felge1966/Picox-8/README.md

PicoX-8: Universalerweiterung für den Epson PX-8

https://forum.classic-computing.de/forum/index.php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

PicoX-8 Block Diagram
