felge1966/Picox-8/PicoX-8 Block Diagram.png

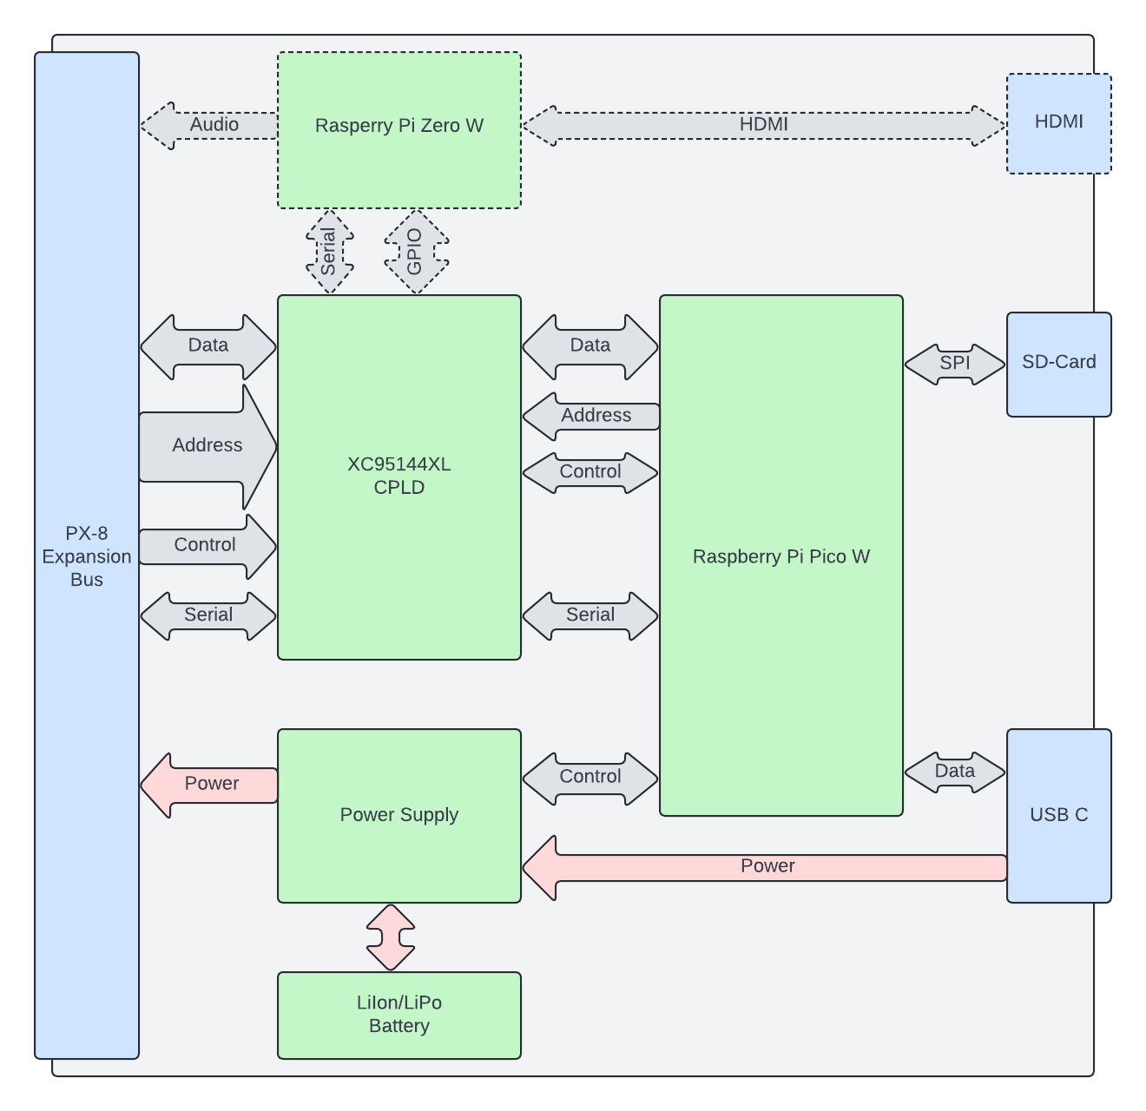
PicoX-8 Block Diagram.png
