felge1966/Picox-8/pcb/3dmodels/SD_Card.step

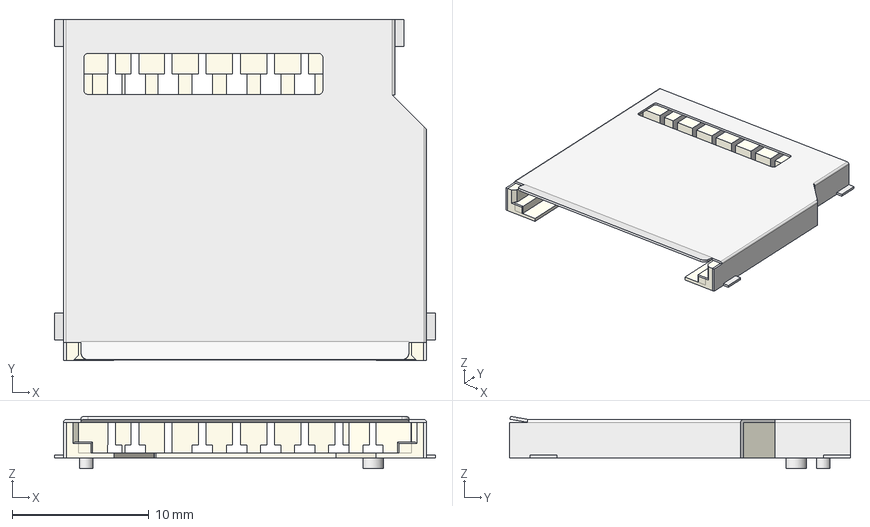
[picture p2: CAD file, 2024-11-17]
pcb/3dmodels/SD_Card.step
27.9 x 25.0 x 3.84 mm
Metal_Case
Bottom_Socket
