felge1966/Picox-8/pcb/3dmodels/Mini-DIN-6P.step

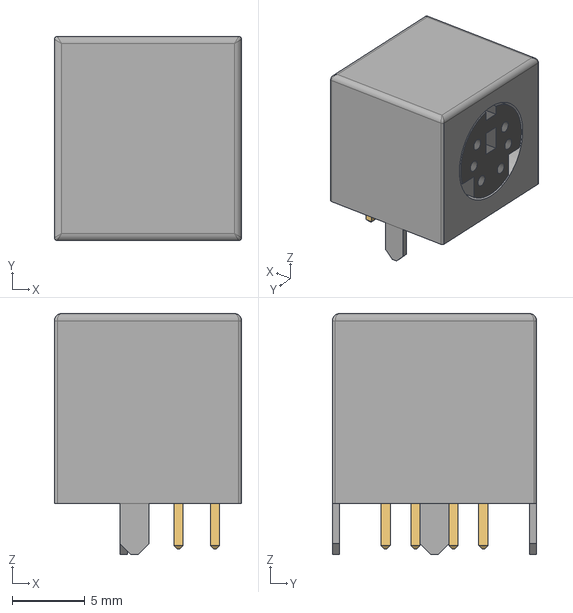
[picture p3: CAD file, 2024-11-17]
pcb/3dmodels/Mini-DIN-6P.step
12.8 x 14.0 x 16.5 mm
