felge1966/Picox-8/pcb/3dmodels/Wuerth SD Card 693063010911.step

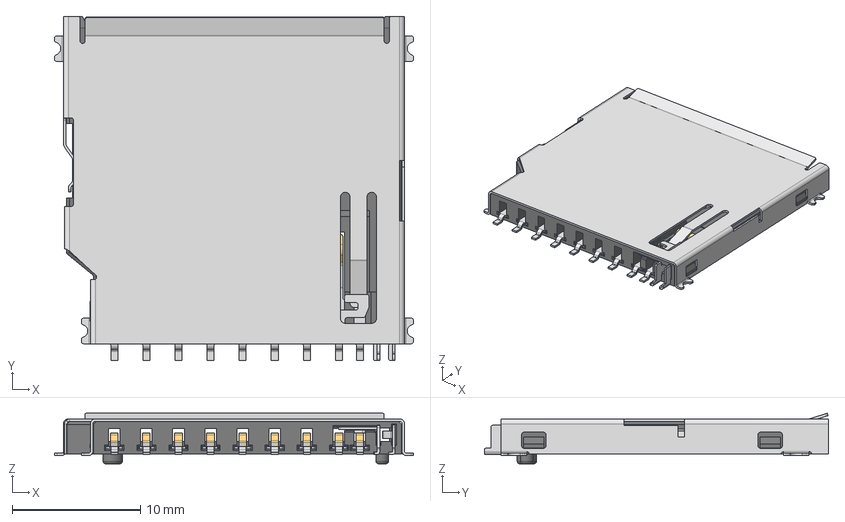
[picture p4: CAD file, 2024-11-17]
pcb/3dmodels/Wuerth SD Card 693063010911.step
28.0 x 26.8 x 3.95 mm
693063010911_Housing
693063010911_PIN_CONTACT
693063010911_PIN_RETENTION
693063010911_PIN_P x 5
693063010911_PIN_M
693063010911_PIN_G x 2
693063010911_PIN_TG
693063010911_Shielding
