felge1966/Picox-8/pcb/picox-8.kicad_pcb

## KiCad design pcb/picox-8.kicad_pcb (2024-11-17)

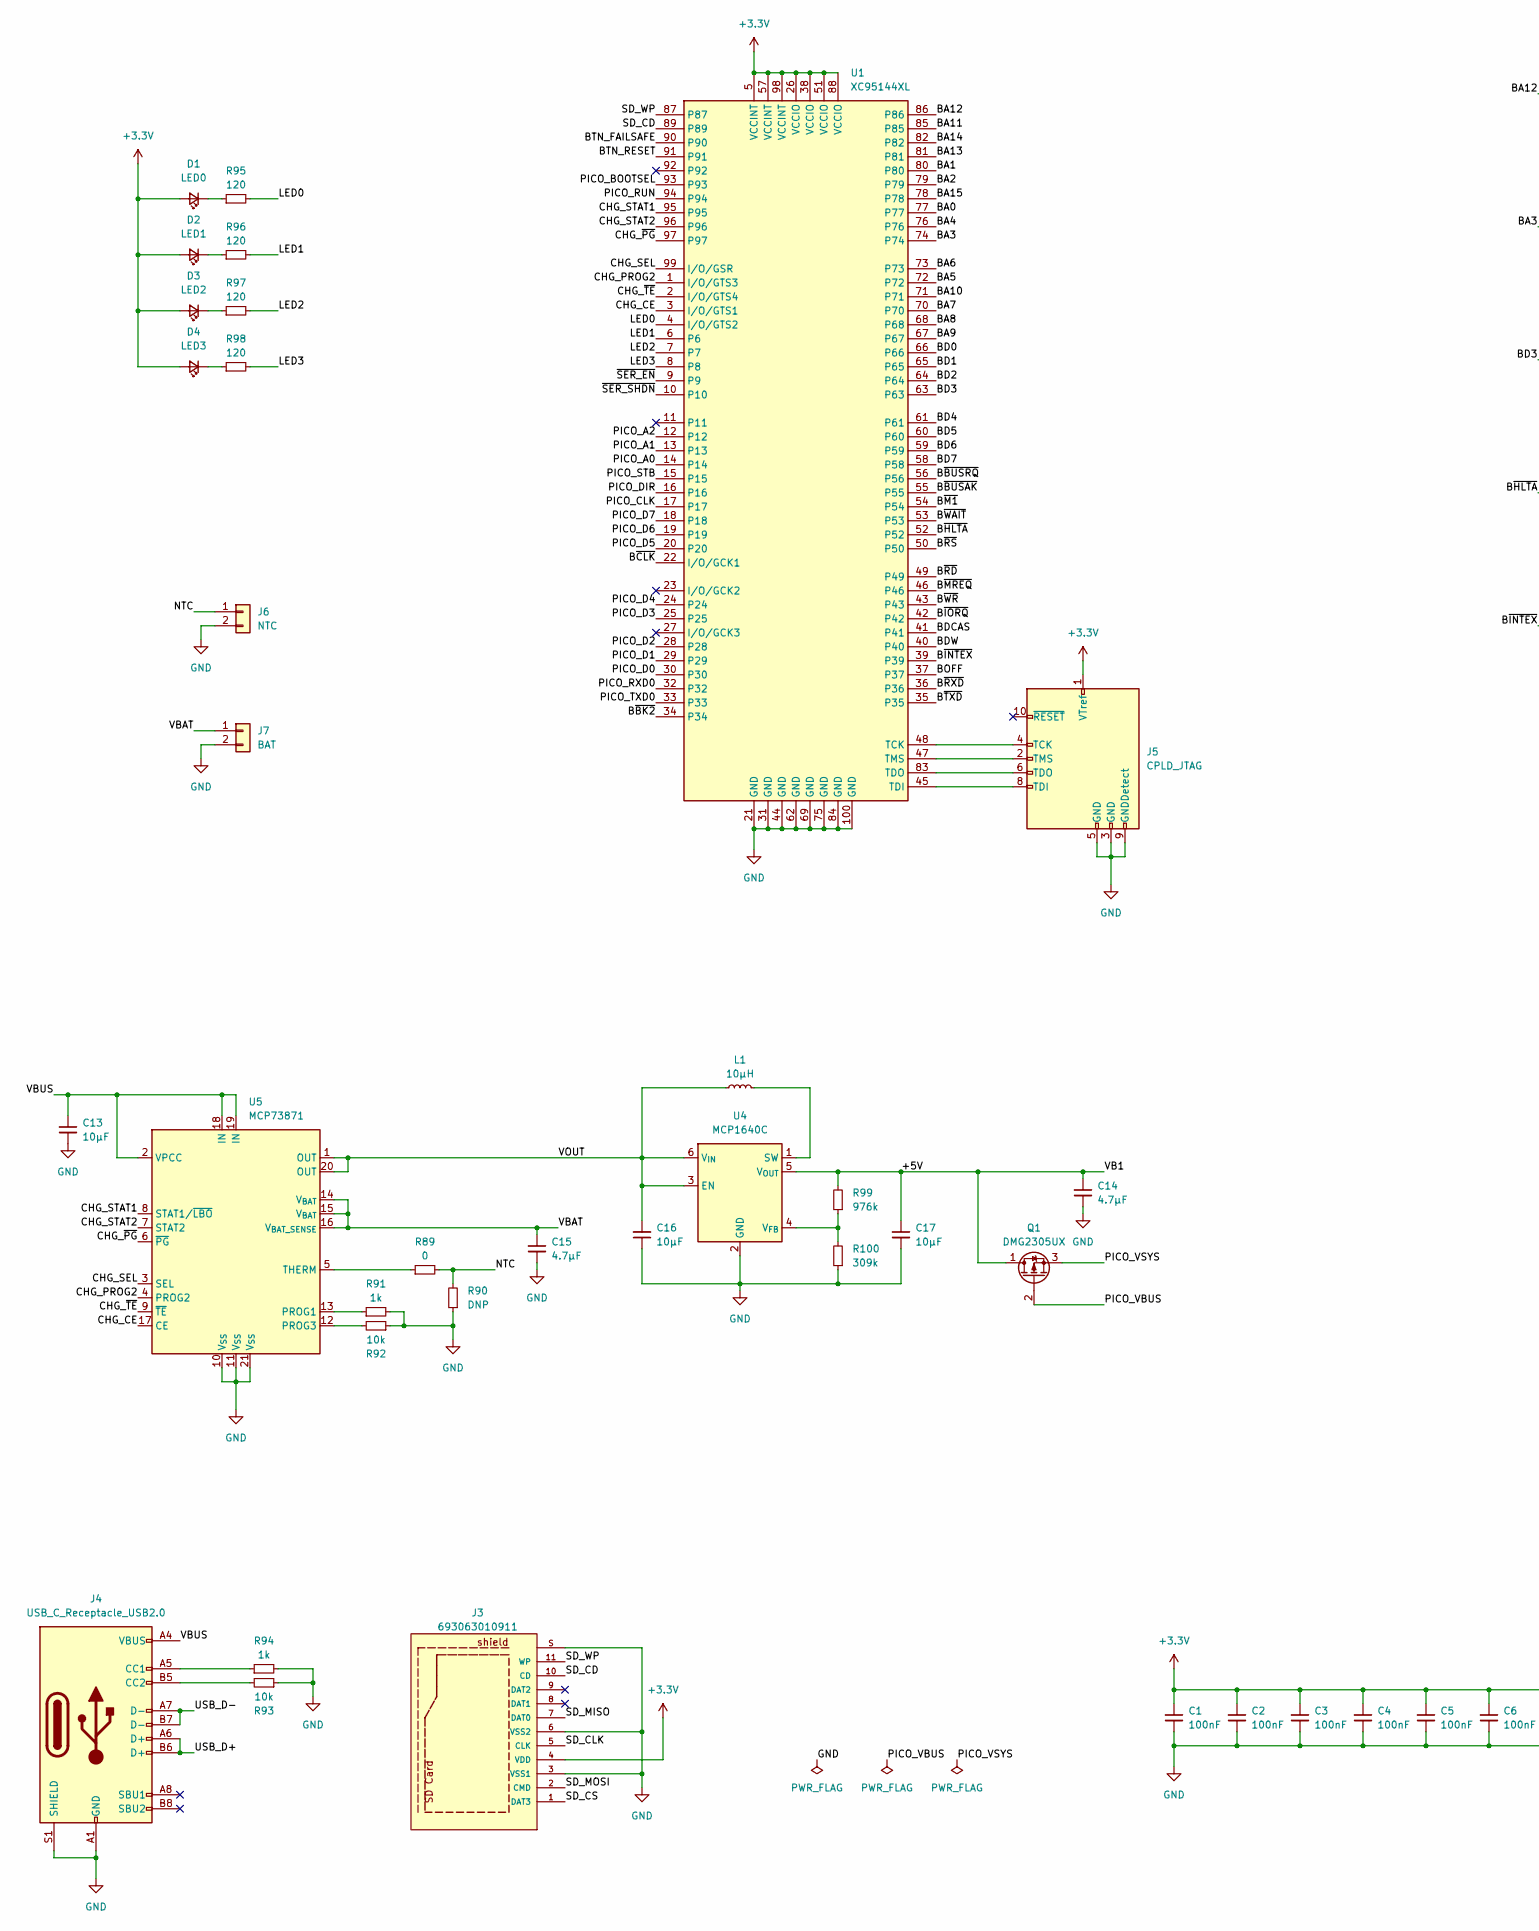
[picture p5: schematic picox-8.kicad_sch, part in row 1, column 1]

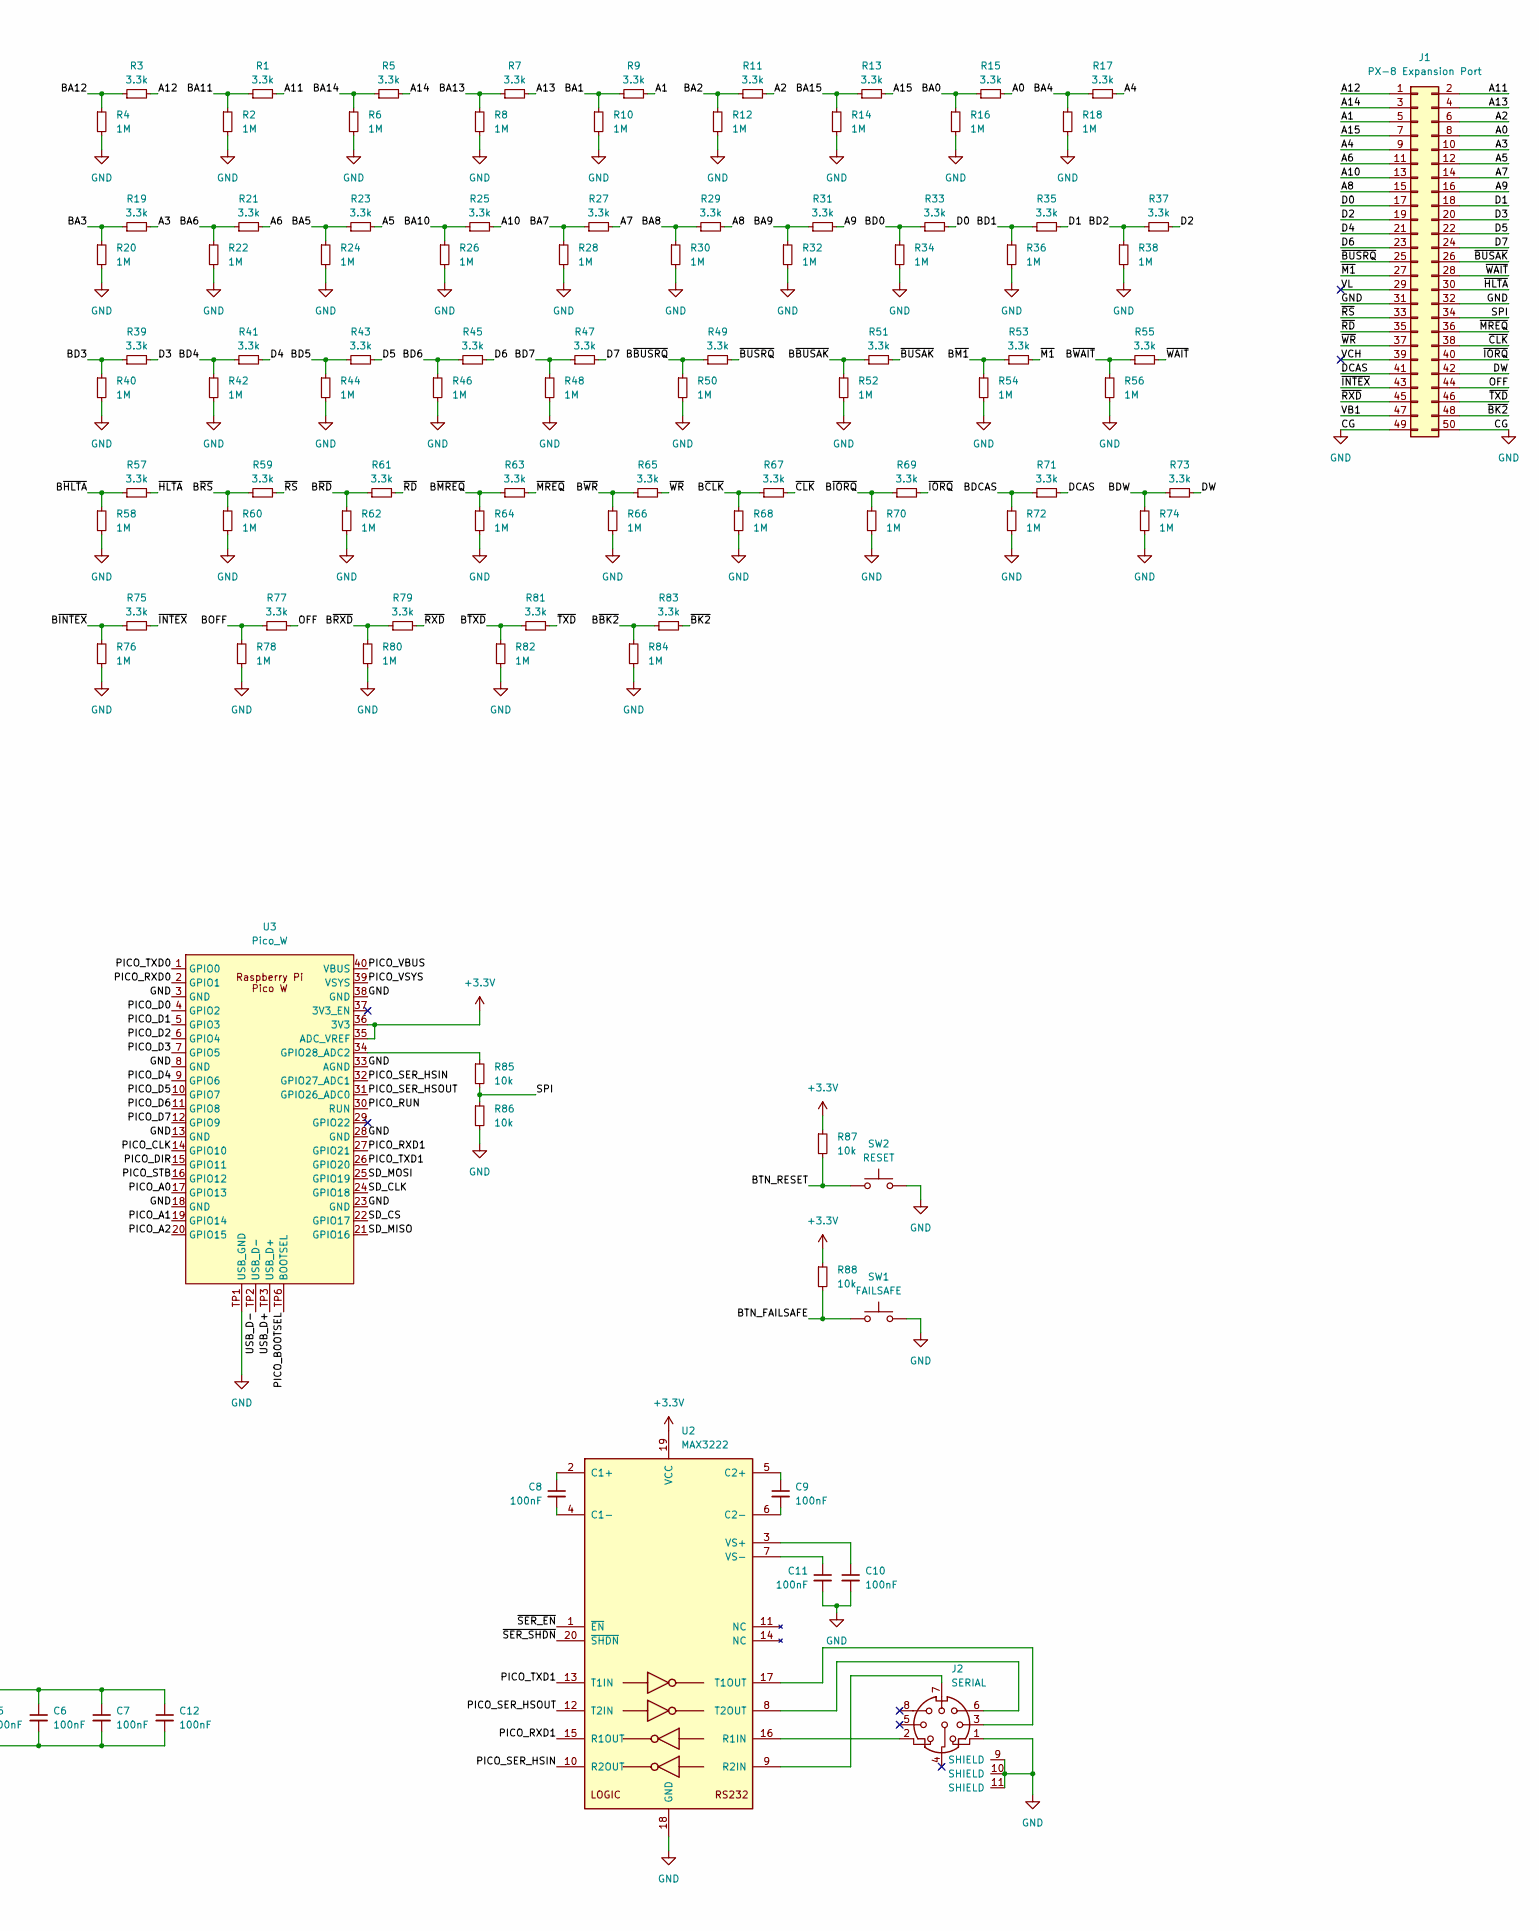
[picture p6: schematic picox-8.kicad_sch, part in row 1, column 2]

Parts:
C1, C2, C3, C4, C5, C6, C7, C8, C9, C10, C11, C12: 100nF; C_0603_1608Metric_Pad1.08x0.95mm_HandSolder
C13, C16, C17: 10μF; C_0603_1608Metric_Pad1.08x0.95mm_HandSolder
C14, C15: 4.7μF; C_0603_1608Metric_Pad1.08x0.95mm_HandSolder
D1: LED0; LED_0603_1608Metric_Pad1.05x0.95mm_HandSolder
D2: LED1; LED_0603_1608Metric_Pad1.05x0.95mm_HandSolder
D3: LED2; LED_0603_1608Metric_Pad1.05x0.95mm_HandSolder
D4: LED3; LED_0603_1608Metric_Pad1.05x0.95mm_HandSolder
J1: PX-8 Expansion Port; IDC-Header_2x25_P2.54mm_Latch_Horizontal
J2: SERIAL; minidin-8
J3: 693063010911; Wuerth SD Card 693063010911; PART-NUMBER 693063010911
J4: USB_C_Receptacle_USB2.0; USB_C_Receptacle_G-Switch_GT-USB-7010ASV
J5: CPLD_JTAG; IDC-Header_2x05_P2.54mm_Vertical
J6: NTC; PinHeader_1x02_P2.54mm_Vertical
J7: BAT; JST_EH_S2B-EH_1x02_P2.50mm_Horizontal
L1: 10µH; L_Radial_D6.0mm_P4.00mm
Q1: DMG2305UX; SOT-23-3
R1, R3, R5, R7, R9, R11, R13, R15, R17, R19, R21, R23, R25, R27, R29, R31, R33, R35, R37, R39, R41, R43, R45, R47, R49, R51, R53, R55, R57, R59, R61, R63, R65, R67, R69, R71, R73, R75, R77, R79, R81, R83: 3.3k; R_0603_1608Metric_Pad0.98x0.95mm_HandSolder
R2, R4, R6, R8, R10, R12, R14, R16, R18, R20, R22, R24, R26, R28, R30, R32, R34, R36, R38, R40, R42, R44, R46, R48, R50, R52, R54, R56, R58, R60, R62, R64, R66, R68, R70, R72, R74, R76, R78, R80, R82, R84: 1M; R_0603_1608Metric_Pad0.98x0.95mm_HandSolder
R85, R86, R87, R88, R92, R93: 10k; R_0603_1608Metric_Pad0.98x0.95mm_HandSolder
R89: 0; R_0603_1608Metric_Pad0.98x0.95mm_HandSolder
R90: DNP; R_0603_1608Metric_Pad0.98x0.95mm_HandSolder
R91, R94: 1k; R_0603_1608Metric_Pad0.98x0.95mm_HandSolder
R95, R96, R97, R98: 120; R_0603_1608Metric_Pad0.98x0.95mm_HandSolder
R99: 976k; R_0603_1608Metric_Pad0.98x0.95mm_HandSolder
R100: 309k; R_0603_1608Metric_Pad0.98x0.95mm_HandSolder
SW1: FAILSAFE; SW_Tactile_SPST_Angled_PTS645Vx39-2LFS
SW2: RESET; SW_Tactile_SPST_Angled_PTS645Vx39-2LFS
U1: XC95144XL; TQFP-100_14x14mm_P0.5mm
U2: MAX3222; TSSOP-20_4.4x6.5mm_P0.65mm
U3: Pico_W; RPI Pico W USB and Prog
U4: MCP1640C; SOT-23-6
U5: MCP73871; QFN-20-1EP_4x4mm_P0.5mm_EP2.5x2.5mm

Connections:
+3.3V: C1.1, C2.1, C3.1, C4.1, C5.1, C6.1, C7.1, C12.1, D1.2 (A), D2.2 (A), D3.2 (A), D4.2 (A), J3.4 (VDD), J5.1 (VTref), R87.1, R88.1, U1.5 (VCCINT), U1.26 (VCCIO), U1.38 (VCCIO), U1.51 (VCCIO), U1.57 (VCCINT), U1.88 (VCCIO), U1.98 (VCCINT), U2.19 (VCC), U3.35 (ADC_VREF), U3.36 (3V3)
/+5V: C14.1, C17.1, J1.47 (VB1), Q1.1 (D), R99.2, U4.5 (V_{OUT})
/A0: J1.8 (A0), R15.2
/A1: J1.5 (A1), R9.2
/A2: J1.6 (A2), R11.2
/A3: J1.10 (A3), R19.2
/A4: J1.9 (A4), R17.2
/A5: J1.12 (A5), R23.2
/A6: J1.11 (A6), R21.2
/A7: J1.14 (A7), R27.2
/A8: J1.15 (A8), R29.2
/A9: J1.16 (A9), R31.2
/A10: J1.13 (A10), R25.2
/A11: J1.2 (A11), R1.2
/A12: J1.1 (A12), R3.2
/A13: J1.4 (A13), R7.2
/A14: J1.3 (A13), R5.2
/A15: J1.7 (A15), R13.2
/BA0: R15.1, R16.1, U1.77
/BA1: R9.1, R10.1, U1.80
/BA2: R11.1, R12.1, U1.79
/BA3: R19.1, R20.1, U1.74
/BA4: R17.1, R18.1, U1.76
/BA5: R23.1, R24.1, U1.72
/BA6: R21.1, R22.1, U1.73
/BA7: R27.1, R28.1, U1.70
/BA8: R29.1, R30.1, U1.68
/BA9: R31.1, R32.1, U1.67
/BA10: R25.1, R26.1, U1.71
/BA11: R1.1, R2.1, U1.85
/BA12: R3.1, R4.1, U1.86
/BA13: R7.1, R8.1, U1.81
/BA14: R5.1, R6.1, U1.82
/BA15: R13.1, R14.1, U1.78
/BD0: R33.1, R34.1, U1.66
/BD1: R35.1, R36.1, U1.65
/BD2: R37.1, R38.1, U1.64
/BD3: R39.1, R40.1, U1.63
/BD4: R41.1, R42.1, U1.61
/BD5: R43.1, R44.1, U1.60
/BD6: R45.1, R46.1, U1.59
/BD7: R47.1, R48.1, U1.58
/BDCAS: R71.1, R72.1, U1.41
/BDW: R73.1, R74.1, U1.40
/BOFF: R77.1, R78.1, U1.37
/BTN_FAILSAFE: R88.2, SW1.1, U1.90
/BTN_RESET: R87.2, SW2.1, U1.91
/B~BK2: R83.1, R84.1, U1.34
/B~BUSAK: R51.1, R52.1, U1.55
/B~BUSRQ: R49.1, R50.1, U1.56
/B~CLK: R67.1, R68.1, U1.22 (I/O/GCK1)
/B~HLTA: R57.1, R58.1, U1.52
/B~INTEX: R75.1, R76.1, U1.39
/B~IORQ: R69.1, R70.1, U1.42
/B~M1: R53.1, R54.1, U1.54
/B~MREQ: R63.1, R64.1, U1.46
/B~RD: R61.1, R62.1, U1.49
/B~RS: R59.1, R60.1, U1.50
/B~RXD: R79.1, R80.1, U1.36
/B~TXD: R81.1, R82.1, U1.35
/B~WAIT: R55.1, R56.1, U1.53
/B~WR: R65.1, R66.1, U1.43
/CHG_CE: U1.3 (I/O/GTS1), U5.17 (CE)
/CHG_PROG2: U1.1 (I/O/GTS3), U5.4 (PROG2)
/CHG_SEL: U1.99 (I/O/GSR), U5.3 (SEL)
/CHG_STAT1: U1.95, U5.8 (STAT1/~LBO)
/CHG_STAT2: U1.96, U5.7 (STAT2)
/CHG_~PG: U1.97, U5.6 (~PG)
/CHG_~TE: U1.2 (I/O/GTS4), U5.9 (~TE)
/D0: J1.17 (D0), R33.2
/D1: J1.18 (D1), R35.2
/D2: J1.19 (D2), R37.2
/D3: J1.20 (D3), R39.2
/D4: J1.21 (D4), R41.2
/D5: J1.22 (D5), R43.2
/D6: J1.23 (D6), R45.2
/D7: J1.24 (D7), R47.2
/DCAS: J1.41 (DCAS), R71.2
/DW: J1.42 (DW), R73.2
/LED0: R95.2, U1.4 (I/O/GTS2)
/LED1: R96.2, U1.6
/LED2: R97.2, U1.7
/LED3: R98.2, U1.8
/NTC: J6.1, R89.2, R90.2
/OFF: J1.44 (OFF), R77.2
/PICO_A0: U1.14, U3.17 (GPIO13)
/PICO_A1: U1.13, U3.19 (GPIO14)
/PICO_A2: U1.12, U3.20 (GPIO15)
/PICO_BOOTSEL: U1.93, U3.TP6 (BOOTSEL)
/PICO_CLK: U1.17, U3.14 (GPIO10)
/PICO_D0: U1.30, U3.4 (GPIO2)
/PICO_D1: U1.29, U3.5 (GPIO3)
/PICO_D2: U1.28, U3.6 (GPIO4)
/PICO_D3: U1.25, U3.7 (GPIO5)
/PICO_D4: U1.24, U3.9 (GPIO6)
/PICO_D5: U1.20, U3.10 (GPIO7)
/PICO_D6: U1.19, U3.11 (GPIO8)
/PICO_D7: U1.18, U3.12 (GPIO9)
/PICO_DIR: U1.16, U3.15 (GPIO11)
/PICO_RUN: U1.94, U3.30 (RUN)
/PICO_RXD0: U1.32, U3.2 (GPIO1)
/PICO_RXD1: U2.15 (R1OUT), U3.27 (GPIO21)
/PICO_SER_HSIN: U2.10 (R2OUT), U3.32 (GPIO27_ADC1)
/PICO_SER_HSOUT: U2.12 (T2IN), U3.31 (GPIO26_ADC0)
/PICO_STB: U1.15, U3.16 (GPIO12)
/PICO_TXD0: U1.33, U3.1 (GPIO0)
/PICO_TXD1: U2.13 (T1IN), U3.26 (GPIO20)
/PICO_VBUS: Q1.2 (G), U3.40 (VBUS)
/PICO_VSYS: Q1.3 (S), U3.39 (VSYS)
/SD_CD: J3.10 (CD), U1.89
/SD_CLK: J3.5 (CLK), U3.24 (GPIO18)
/SD_CS: J3.1 (DAT3), U3.22 (GPIO17)
/SD_MISO: J3.7 (DAT0), U3.21 (GPIO16)
/SD_MOSI: J3.2 (CMD), U3.25 (GPIO19)
/SD_WP: J3.11 (WP), U1.87
/SPI: J1.34 (SPI), R85.2, R86.1
/USB_D+: J4.A6 (D+), J4.B6 (D+), U3.TP3 (USB_D+)
/USB_D-: J4.A7 (D-), J4.B7 (D-), U3.TP2 (USB_D-)
/VBAT: C15.1, J7.1, U5.14 (V_{BAT}), U5.15 (V_{BAT}), U5.16 (V_{BAT_SENSE})
/VBUS: C13.1, J4.A4 (VBUS), J4.A9 (VBUS), J4.B4 (VBUS), J4.B9 (VBUS), U5.2 (VPCC), U5.18 (IN), U5.19 (IN)
/VCH: J1.39 (VCH)
/VL: J1.29 (VL)
/VOUT: C16.2, L1.1, U4.3 (EN), U4.6 (V_{IN}), U5.1 (OUT), U5.20 (OUT)
/~BK2: J1.48 (~BK2), R83.2
/~BUSAK: J1.26 (~BUSAK), R51.2
/~BUSRQ: J1.25 (~BUSRQ), R49.2
/~CLK: J1.38 (~CLK), R67.2
/~HLTA: J1.30 (~HLTA), R57.2
/~INTEX: J1.43 (~INTEX), R75.2
/~IORQ: J1.40 (~IORQ), R69.2
/~M1: J1.27 (~M1), R53.2
/~MREQ: J1.36 (~MREQ), R63.2
/~RD: J1.35 (~RD), R61.2
/~RS: J1.33 (~RESET), R59.2
/~RXD: J1.45 (~RXD), R79.2
/~SER_EN: U1.9, U2.1 (~EN)
/~SER_SHDN: U1.10, U2.20 (~SHDN)
/~TXD: J1.46 (~TXD), R81.2
/~WAIT: J1.28 (~WAIT), R55.2
/~WR: J1.37 (~WR), R65.2
GND: C1.2, C2.2, C3.2, C4.2, C5.2, C6.2, C7.2, C10.2, C11.2, C12.2, C13.2, C14.2, C15.2, C16.1, C17.2, J1.31 (GND), J1.32 (GND), J1.49 (CG), J1.50 (CG), J2.1, J2.9 (SHIELD), J2.10 (SHIELD), J2.11 (SHIELD), J3.3 (VSS1), J3.6 (VSS2), J3.S, J4.A1 (GND), J4.A12 (GND), J4.B1 (GND), J4.B12 (GND), J4.S1 (SHIELD), J5.3 (GND), J5.5 (GND), J5.9 (GNDDetect), J6.2, J7.2, R2.2, R4.2, R6.2, R8.2, R10.2, R12.2, R14.2, R16.2, R18.2, R20.2, R22.2, R24.2, R26.2, R28.2, R30.2, R32.2, R34.2, R36.2, R38.2, R40.2, R42.2, R44.2, R46.2, R48.2, R50.2, R52.2, R54.2, R56.2, R58.2, R60.2, R62.2, R64.2, R66.2, R68.2, R70.2, R72.2, R74.2, R76.2, R78.2, R80.2, R82.2, R84.2, R86.2, R90.1, R91.2, R92.1, R93.1, R94.2, R100.1, SW1.2, SW2.2, U1.21 (GND), U1.31 (GND), U1.44 (GND), U1.62 (GND), U1.69 (GND), U1.75 (GND), U1.84 (GND), U1.100 (GND), U2.18 (GND), U3.3 (GND), U3.8 (GND), U3.13 (GND), U3.18 (GND), U3.23 (GND), U3.28 (GND), U3.33 (AGND), U3.38 (GND), U3.TP1 (USB_GND), U4.2 (GND), U5.10 (V_{SS}), U5.11 (V_{SS}), U5.21 (V_{SS})
unnamed: D1.1 (K), R95.1
unnamed: D2.1 (K), R96.1
unnamed: D3.1 (K), R97.1
unnamed: D4.1 (K), R98.1
unnamed: J4.A5 (CC1), R94.1
unnamed: J4.B5 (CC2), R93.2
unnamed: J5.4 (TCK), U1.48 (TCK)
unnamed: J5.8 (TDI), U1.45 (TDI)
unnamed: J5.6 (TDO), U1.83 (TDO)
unnamed: J5.2 (TMS), U1.47 (TMS)
unnamed: C8.1, U2.2 (C1+)
unnamed: C8.2, U2.4 (C1-)
unnamed: C9.1, U2.5 (C2+)
unnamed: C9.2, U2.6 (C2-)
unnamed: J2.2, U2.16 (R1IN)
unnamed: J2.7, U2.9 (R2IN)
unnamed: J2.3, U2.17 (T1OUT)
unnamed: J2.6, U2.8 (T2OUT)
unnamed: C10.1, U2.3 (VS+)
unnamed: C11.1, U2.7 (VS-)
unnamed: R85.1, U3.34 (GPIO28_ADC2)
unnamed: L1.2, U4.1 (SW)
unnamed: R99.1, R100.2, U4.4 (V_{FB})
unnamed: R91.1, U5.13 (PROG1)
unnamed: R92.2, U5.12 (PROG3)
unnamed: R89.1, U5.5 (THERM)

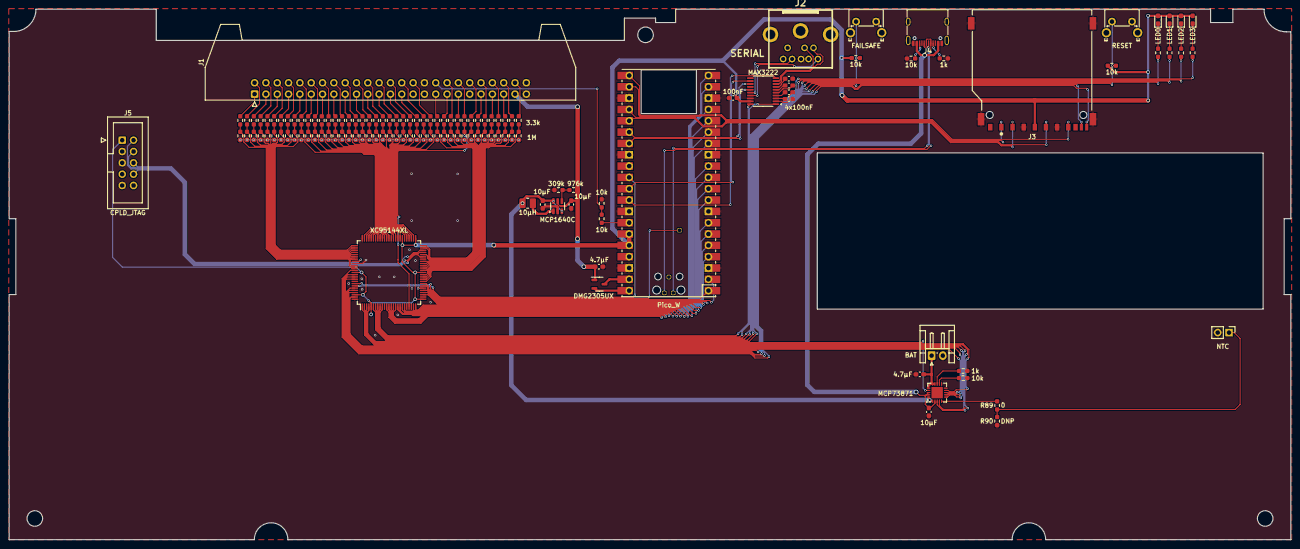
[picture p7: board picox-8.kicad_pcb from above]

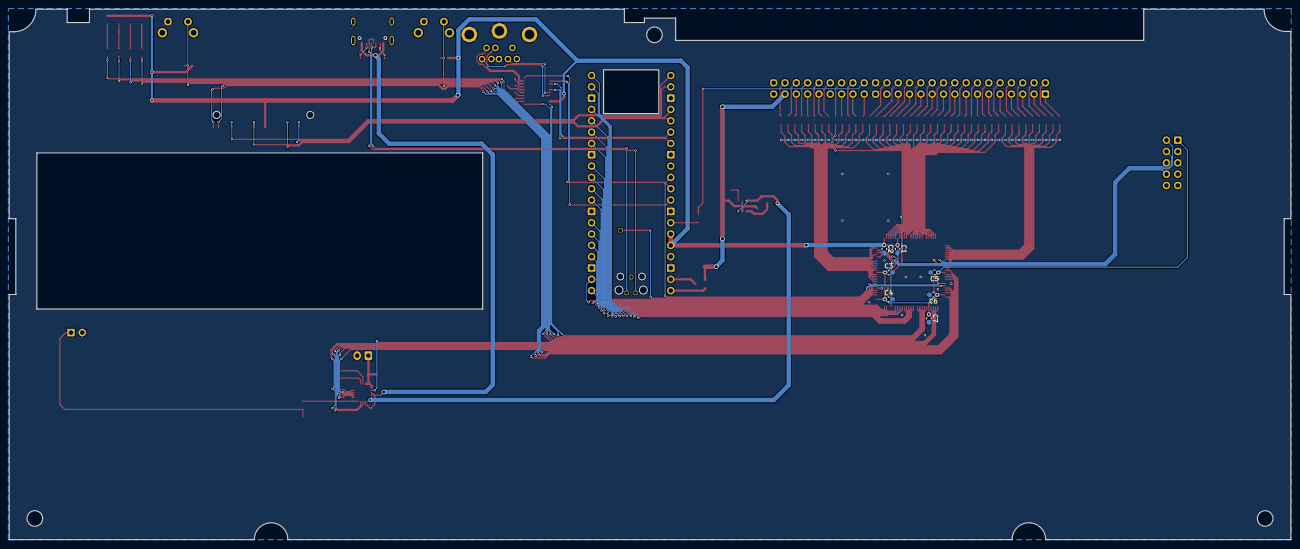
[picture p8: board picox-8.kicad_pcb from below]

Board: 2 copper layers, 287.5 x 119.0 mm, 137 parts (7 on the bottom side), 165 nets.
