felge1966/Picox-8/firmware/cpld.py

from machine import Pin, UART
import rp2
from rp2 import PIO

# Pin assignments
PIN_DATA = [Pin(i, Pin.IN) for i in range(2, 10)]
PIN_CLK = Pin(10, Pin.IN)
PIN_DIR = Pin(11, Pin.OUT, Pin.PULL_DOWN)
PIN_STB = Pin(12, Pin.OUT, Pin.PULL_DOWN)
PIN_ADDR = [Pin(i, Pin.OUT) for i in range(13, 16)]

ADDR_BITS_POS = 11 # relative to pin 2

# Bit mask for 32 bit command word that is sent from MicroPython to
# the PIO state machine.  The upper half of this command word defines
# the direction bits, the lower half defines the data bits.  DIR, STB
# and the ADDR bits are always configured as outputs.  When writing,
# the data bits are also configured as outputs, and the DIR bit is set
# to one.  The MSB is an additional read/write indicator that needs to
# be set to 1 for read operations.  It is used by the PIO state
# machine to skip reading from the data lines into the FIFO when
# writing.
STB_MASK   = 0b00111110_00000000_00000100_00000000
READ_MASK  = 0b10000000_00000000_00000000_00000000
WRITE_MASK = 0b00000000_11111111_00000010_00000000

# IRQ register bits
IRQ_TONE_DIALER     = 0x01
IRQ_MODEM_CONTROL   = 0x02
IRQ_RAMDISK_COMMAND = 0x04
IRQ_RAMDISK_OBF     = 0x08
IRQ_RAMDISK_IBF     = 0x10
IRQ_BAUDRATE        = 0x20
IRQ_MISC_CONTROL    = 0x40

# Register numbers
REG_TONE_DIALER     = 0
REG_MODEM_CONTROL   = 1
REG_MODEM_STATUS    = 2
REG_RAMDISK_DATA    = 3
REG_RAMDISK_CONTROL = 4
REG_BAUDRATE        = 5
REG_MISC_CONTROL    = 6
REG_IRQ             = 7

# PIO program to communicate to the CPLD
@rp2.asm_pio(out_shiftdir=PIO.SHIFT_RIGHT,
             out_init=(PIO.IN_LOW,)*8 + (PIO.IN_LOW, PIO.OUT_LOW, PIO.OUT_LOW) + (PIO.OUT_LOW,)*3,
             autopush=False, autopull=False)
def cpld_interface():
    CLK_PIN = 8 # (GP10)
    # Pull 32-bit value from FIFO
    pull()

    # Wait for rising edge on CLK
    wait(0, pin, CLK_PIN)
    wait(1, pin, CLK_PIN)

    # Output data bits to pins (DATA, CLK, DIR, STB, ADDR + extra)
    out(pins, 16)
    # Output pindirs bits to set pin directions
    out(pindirs, 15)

    # Wait for falling edge on CLK
    wait(0, pin, CLK_PIN)

    # Skip reading for write operation
    mov(x, osr)
    jmp(not_x, "finish_cycle")

    # Read 8 bits from input pins to ISR
    in_(pins, 8)
    # Push ISR content to FIFO
    push()

    label("finish_cycle")
    # Wait for next rising CLK edge to complete cycle
    wait(1, pin, CLK_PIN)

    # Set all outputs to zero
    mov(osr, null)
    out(pins, 16)
    # Set all pindirs to zero (input)
    out(pindirs, 16)


# Create and configure the state machine
cpld_sm = rp2.StateMachine(0, cpld_interface, freq=24_000_000, in_base=Pin(2), out_base=Pin(2))
cpld_sm.active(1)


# Initialize the state machine
def write_reg(address, data):
    cpld_sm.put((address << ADDR_BITS_POS) | STB_MASK | WRITE_MASK | data)


def read_reg(address):
    cpld_sm.put((address << ADDR_BITS_POS) | STB_MASK | READ_MASK)
    return cpld_sm.get()
