felge1966/Picox-8/(commit log)

2024-07-09 switch to xc95144xl in tq100 package
2024-07-09 buffer leds so that they are initialized properly
2024-07-11 connect pico and cpld + start of firmware
2024-07-13 fix over-eager driving of data bus
    [picox-8.vhd]
2024-07-13 skip reading data when writing
    [picox8.py]
2024-07-23 can read some bytes from px-8 (still missing first one)
    [picox-8.ucf, picox-8.vhd, picox8.py]
2024-07-23 add sample ramdisk image
2024-07-25 some pcb progress
    [picox-8.kicad_pcb, picox-8.kicad_sch]
2024-07-27 switch off tone generators when resetting modem
    [modem.py]
2024-07-31 echo uart data by default
2024-07-31 sdcard error handling, modem power control
    [cpld.py, modem.py, picox-8.vhd, picox8.py, ramdisk.py]
2024-07-31 delay modem reset when disabled
    this is to accommodate DAKCOMM's behavior
    [picox8.py]
2024-08-02 add bus current limiting and pull resistors
    [picox-8.kicad_pcb, picox-8.kicad_sch]
2024-08-02 bus buffer resistors
    [picox-8.kicad_pcb]
2024-08-02 hide resistor silkscreen markings
    [picox-8.kicad_pcb]
2024-08-03 PCB work
    [Mini-DIN-6P.step, SD_Card.step, picox-8.kicad_pcb, picox-8.kicad_sch]
2024-08-06 cpld & pcb work
    [picox-8.kicad_pcb, picox-8.kicad_sch]
2024-08-06 schematics work: buttons hooked up
    [picox-8.kicad_sch]
2024-08-09 schematic nearing completion
    [picox-8.kicad_pcb, picox-8.kicad_sch]
2024-08-10 erc fixes
    [picox-8.kicad_pcb, picox-8.kicad_sch]
2024-08-10 layout work
    [picox-8.kicad_pcb]
2024-08-11 routing complete
    [picox-8.kicad_pcb, picox-8.kicad_sch]
2024-08-11 remove kiutils based script as it does not support kicad 8
2024-08-12 more pcb work
    [picox-8.kicad_pcb, picox-8.kicad_sch]
2024-08-15 prototype hardware support re-added
2024-08-31 tools to extract cpld pins from schematic
2024-08-31 Adapt to v1 PCB
2024-08-31 charger & serial port signals setup
2024-08-31 first version sent to jlcpcb for production
    [picox-8.kicad_pcb]
2024-08-31 adapt to pcb-1
2024-09-14 some life is in the board
